Jormunth/EUC_Blinker_CPELyon/IMU/data_processing/peak_detection/img/peak_detection_2_shake_right.png

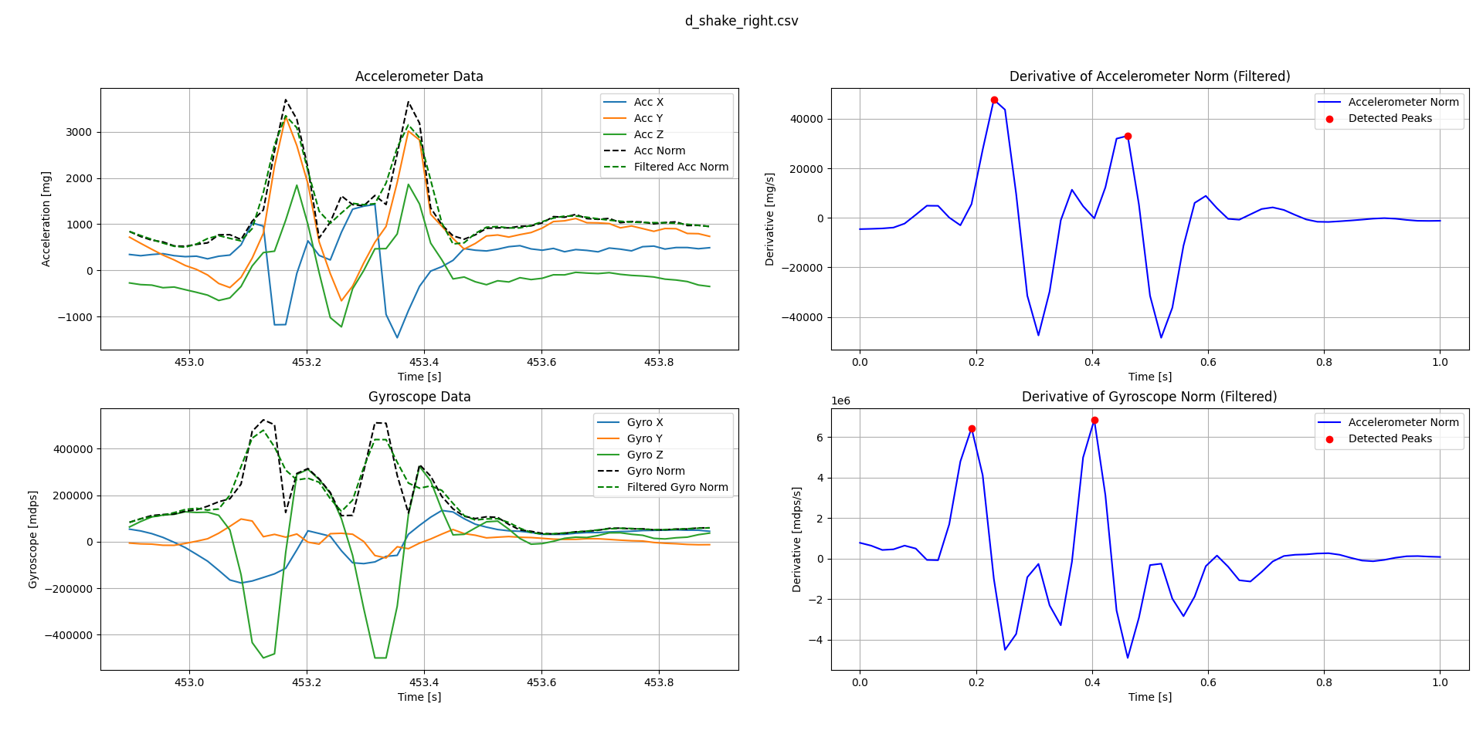
IMU/data_processing/peak_detection/img/peak_detection_2_shake_right.png
