Jormunth/EUC_Blinker_CPELyon/IMU/img/illustration.png

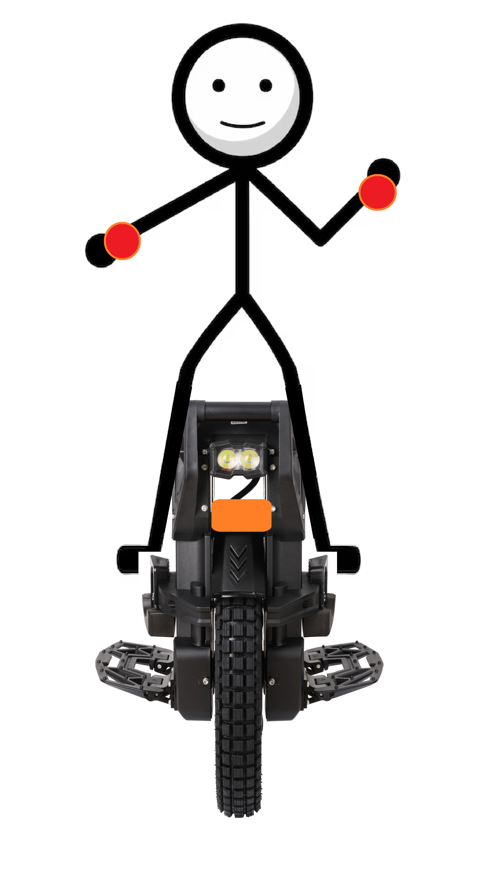
IMU/img/illustration.png
