Jormunth/EUC_Blinker_CPELyon/IMU/img/jack_port_HW.jpg

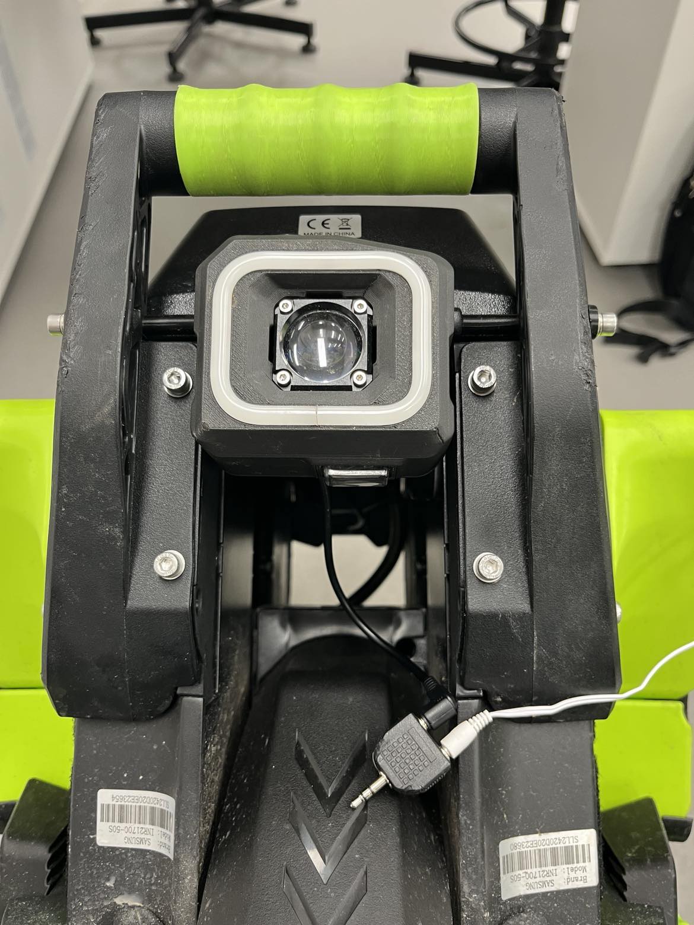
IMU/img/jack_port_HW.jpg
