Jormunth/EUC_Blinker_CPELyon/TOF/img/capteur_valor.png

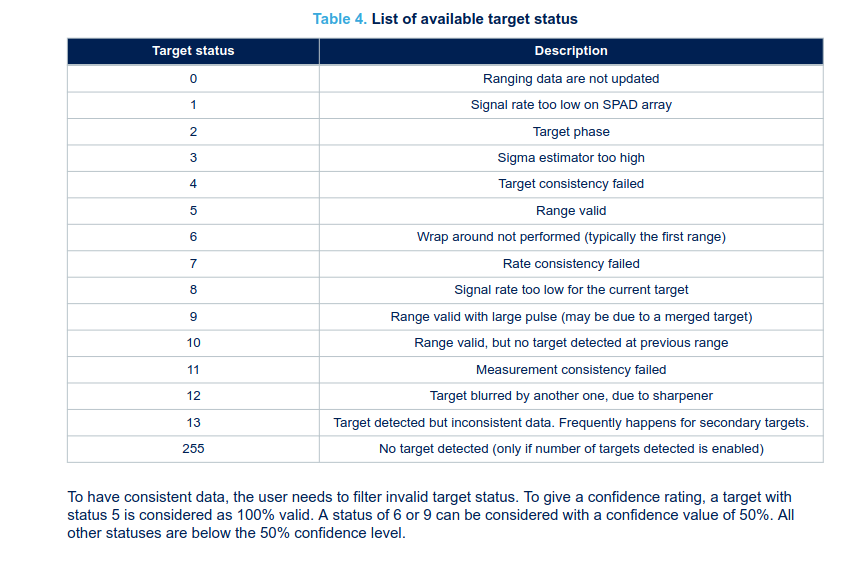
TOF/img/capteur_valor.png
