Jormunth/EUC_Blinker_CPELyon/TOF/img/serial_gui.png

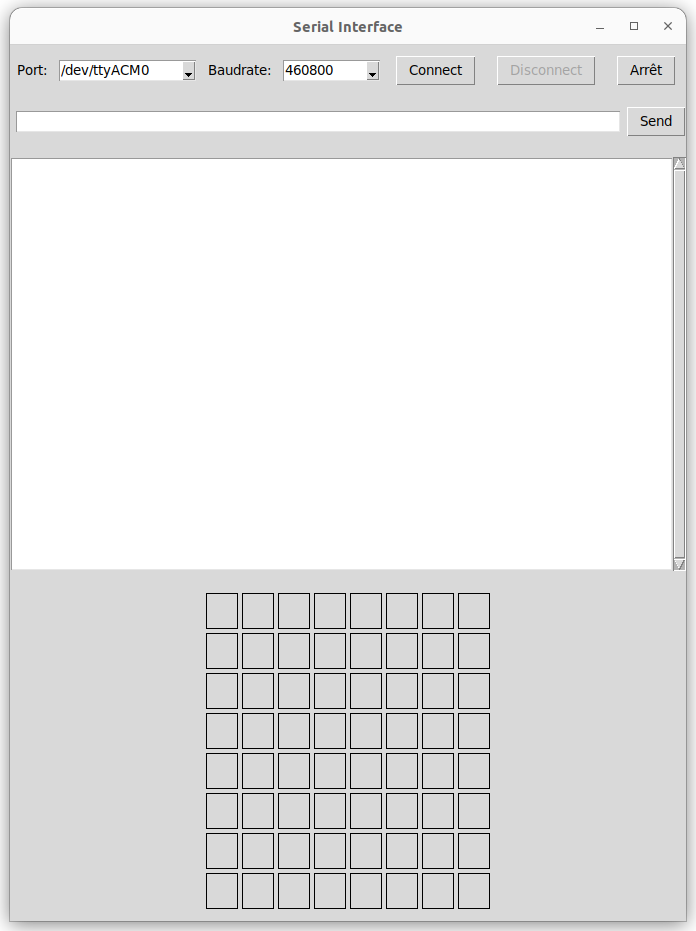
TOF/img/serial_gui.png
