Jormunth/EUC_Blinker_CPELyon/IMU/data_processing/peak_detection/logs/saturation_test.csv

# IKS01A3
time[us] | acc_x[mg] | acc_y[mg] | acc_z[mg] | gyro_x[mdps] | gyro_y[mdps] | gyro_z[mdps]
1092189000 | 1050 | 42 | -43 | -2045 | -1404 | -351
1092208000 | 1055 | 40 | -41 | -1954 | -1450 | -366
1092227000 | 1045 | 39 | -43 | -2091 | -1404 | -244
1092246000 | 1048 | 43 | -40 | -2015 | -1419 | -305
1092265000 | 1048 | 43 | -50 | -1954 | -1404 | -290
1092284000 | 1051 | 45 | -42 | -1938 | -1419 | -213
1092303000 | 1048 | 41 | -48 | -2152 | -1297 | -351
1092322000 | 1055 | 44 | -44 | -2061 | -1358 | -381
1092341000 | 1054 | 41 | -51 | -2091 | -1358 | -274
1092360000 | 1047 | 38 | -42 | -2213 | -1465 | -351
1092379000 | 1056 | 44 | -45 | -2091 | -1419 | -335
1092398000 | 1051 | 39 | -42 | -2000 | -1404 | -335
1092417000 | 1046 | 40 | -36 | -2030 | -1282 | -137
1092436000 | 1053 | 43 | -43 | -2076 | -1206 | -305
1092455000 | 1050 | 46 | -41 | -1893 | -1480 | -305
1092474000 | 1051 | 39 | -48 | -2091 | -1419 | -351
1092493000 | 1052 | 46 | -38 | -2061 | -1297 | -290
1092512000 | 1053 | 46 | -36 | -2000 | -1312 | -290
1092531000 | 1053 | 38 | -52 | -1954 | -1450 | -351
1092550000 | 1049 | 42 | -50 | -1984 | -1496 | -458
1092569000 | 1044 | 39 | -45 | -2030 | -1511 | -335
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
