Jormunth/EUC_Blinker_CPELyon/IMU/data_processing/peak_detection/logs/test_d_shake.csv

# IKS01A3
time[us] | acc_x[mg] | acc_y[mg] | acc_z[mg] | gyro_x[mdps] | gyro_y[mdps] | gyro_z[mdps]
23576000 | 944 | 349 | 254 | -2992 | -2000 | -946
23595000 | 932 | 368 | 243 | -1190 | -1175 | -1832
23614000 | 959 | 339 | 247 | -656 | -1312 | 625
23633000 | 965 | 311 | 246 | -2427 | -3328 | 183
23652000 | 940 | 337 | 245 | -2000 | -3083 | -442
23671000 | 947 | 319 | 244 | -2580 | -2900 | -1404
23690000 | 923 | 358 | 247 | -2854 | -3022 | -183
23709000 | 934 | 346 | 250 | -1877 | -3053 | 610
23728000 | 928 | 353 | 256 | -534 | -2167 | 1190
23747000 | 931 | 314 | 250 | 15 | -1114 | 2091
23766000 | 929 | 312 | 250 | -870 | -1557 | 1312
23785000 | 921 | 316 | 230 | -1648 | -1251 | 2977
23804000 | 898 | 328 | 231 | -2274 | -763 | 4595
23823000 | 893 | 331 | 236 | -2167 | 1435 | 5267
23842000 | 912 | 323 | 236 | -2305 | 2045 | 5099
23861000 | 923 | 334 | 243 | -2076 | 2366 | 5526
23880000 | 918 | 340 | 243 | -2335 | 2732 | 6045
23899000 | 929 | 331 | 248 | -2854 | 2854 | 7938
23918000 | 929 | 324 | 251 | -2534 | 3618 | 9923
23937000 | 959 | 289 | 240 | -2732 | 3908 | 8687
23956000 | 965 | 277 | 245 | -4381 | 4229 | 8274
23975000 | 995 | 279 | 260 | -5954 | 3786 | 5893
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
