Jormunth/EUC_Blinker_CPELyon/IMU/data_processing/turn_detection/logs/test1.csv

Timestamp | Data
2025-01-20T15:13:03.856857 | 176.57 | 1.08 | -3.77
2025-01-20T15:13:03.857879 | 176.57 | 1.09 | -3.77
2025-01-20T15:13:03.870691 | 176.57 | 1.10 | -3.77
2025-01-20T15:13:03.886467 | 176.56 | 1.11 | -3.77
2025-01-20T15:13:03.887480 | 176.55 | 1.12 | -3.77
2025-01-20T15:13:03.901293 | 176.54 | 1.14 | -3.78
2025-01-20T15:13:03.902751 | 176.52 | 1.15 | -3.79
2025-01-20T15:13:03.916365 | 176.50 | 1.17 | -3.79
2025-01-20T15:13:03.946944 | 176.48 | 1.18 | -3.80
2025-01-20T15:13:03.947955 | 176.45 | 1.20 | -3.79
2025-01-20T15:13:03.960804 | 176.43 | 1.22 | -3.80
2025-01-20T15:13:03.961812 | 176.39 | 1.23 | -3.81
2025-01-20T15:13:03.975381 | 176.37 | 1.24 | -3.82
2025-01-20T15:13:03.983849 | 176.33 | 1.25 | -3.83
2025-01-20T15:13:03.990965 | 176.29 | 1.26 | -3.84
2025-01-20T15:13:03.991976 | 176.25 | 1.26 | -3.84
2025-01-20T15:13:04.006656 | 176.20 | 1.26 | -3.85
2025-01-20T15:13:04.020812 | 176.14 | 1.26 | -3.86
2025-01-20T15:13:04.021796 | 176.09 | 1.26 | -3.88
2025-01-20T15:13:04.051287 | 176.02 | 1.26 | -3.89
2025-01-20T15:13:04.052299 | 175.95 | 1.26 | -3.90
2025-01-20T15:13:04.053486 | 175.86 | 1.26 | -3.90
2025-01-20T15:13:04.066063 | 175.78 | 1.26 | -3.92
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
