Jormunth/EUC_Blinker_CPELyon/IMU/data_processing/turn_detection/logs/test3.csv

Timestamp | Data
2025-01-20T15:15:21.084162 | -4.85 | -0.59 | -1.80
2025-01-20T15:15:21.099340 | -4.85 | -0.59 | -1.77
2025-01-20T15:15:21.129811 | -4.86 | -0.61 | -1.74
2025-01-20T15:15:21.143798 | -4.86 | -0.63 | -1.72
2025-01-20T15:15:21.158805 | -4.86 | -0.64 | -1.72
2025-01-20T15:15:21.219418 | -4.86 | -0.65 | -1.76
2025-01-20T15:15:21.234577 | -4.89 | -0.72 | -1.72
2025-01-20T15:15:21.278609 | -4.90 | -0.75 | -1.73
2025-01-20T15:15:21.280070 | -4.91 | -0.77 | -1.74
2025-01-20T15:15:21.294441 | -4.92 | -0.78 | -1.75
2025-01-20T15:15:21.323464 | -5.02 | -0.92 | -1.82
2025-01-20T15:15:21.338958 | -5.02 | -0.92 | -1.84
2025-01-20T15:15:23.620040 | -6.58 | -7.30 | -1.60
2025-01-20T15:15:23.626132 | -6.41 | -7.32 | -1.53
2025-01-20T15:15:23.677865 | -6.23 | -7.39 | -1.42
2025-01-20T15:15:23.738283 | -6.00 | -7.42 | -1.29
2025-01-20T15:15:23.739703 | -5.75 | -7.44 | -1.18
2025-01-20T15:15:23.858403 | -5.47 | -7.42 | -1.12
2025-01-20T15:15:23.859567 | -5.15 | -7.39 | -1.05
2025-01-20T15:15:23.860665 | -4.81 | -7.36 | -1.01
2025-01-20T15:15:24.037543 | -4.30 | -4.11 | -2.26
2025-01-20T15:15:24.097841 | -4.36 | -3.82 | -2.35
2025-01-20T15:15:24.157722 | -4.40 | -3.80 | -2.09
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
