Jormunth/EUC_Blinker_CPELyon/TOF/Firmware/STM_32_serial/VL53L8CX_SimpleRanging/VL53L8CX_SimpleRanging.ioc

Mcu.UserName=STM32F401RETx
PA13.GPIO_Label=TMS
PA13.Signal=SYS_JTMS-SWDIO
PA14.GPIO_Label=TCK
PA14.Signal=SYS_JTCK-SWCLK
PA2.Signal=USART2_TX
PA3.Signal=USART2_RX
PA4.Signal=GPXTI4
PA5.GPIO_Label=LD2 [Green Led]
PA5.Signal=GPIO_Output
PA7.Signal=GPIO_Output
PB0.Signal=GPIO_Output
PB3.GPIO_Label=SWO
PB3.Signal=SYS_JTDO-SWO
PB8.Signal=I2C1_SCL
PB9.Signal=I2C1_SDA
PC13-ANTI_TAMP.GPIO_Label=B1 [Blue PushButton]
PC13-ANTI_TAMP.Signal=GPXTI13
PC14-OSC32_IN.Signal=RCC_OSC32_IN
PC15-OSC32_OUT.Signal=RCC_OSC32_OUT
