Jormunth/EUC_Blinker_CPELyon/(commit log)

2025-01-06 MEMS data acquisition and logger
    [ble_mpu6050_logs.csv]
2025-01-07 TOF serial GUI fonctionnelle
    [archive_20250107_141829.csv, archive_20250107_142311.csv, archive_20250107_142500.csv, archive_20250107_144902.csv, archive_20250107_145005.csv, archive_20250107_145038.csv, archive_20250107_145111.csv, archive_20250107_145206.csv]
2025-01-07 TOF ble gui
    [archive_20250107_162313.csv]
2025-01-07 IMU visualizer
    [ble_mpu6050_logs.csv]
2025-01-07 fin de journée 2
    [archive_20250107_173458.csv, archive_20250107_173746.csv]
2025-01-07 changed BLE logger format
    [ble_mpu6050_logs.csv]
2025-01-08 modif gui
    [archive_20250108_100935.csv, archive_20250108_101626.csv, archive_20250108_102820.csv]
2025-01-08 fin day 3
    [archive_20250108_150324.csv, archive_20250108_161807.csv, archive_20250108_164744.csv]
2025-01-10 connextion BLE fonctionne
    [archive_20250107_141829.csv, archive_20250107_142311.csv, archive_20250107_142500.csv, archive_20250107_144902.csv, archive_20250107_145005.csv, archive_20250107_145038.csv, archive_20250107_145111.csv, archive_20250107_145206.csv]
2025-01-13 ble logger new
    [out.csv]
2025-01-13 imu logger
    [ble_mpu6050_logs.csv]
2025-01-13 IMU logger BLE
    [Data_Log_25_01_13_14_20_29.csv, out.csv]
2025-01-13 update FW hand
    [out.csv]
2025-01-14 gesture recognition start algo
    [chest_tap.csv, d_shake_left.csv, d_shake_right.csv, other.csv, out.csv, saturation_test.csv, stationnary.csv, test_d_shake.csv]
2025-01-14 debugging in progress classification IMU
2025-01-17 implemented IMU fusion
2025-01-17 logged ypr imu
    [archive_20250117_151727.csv, archive_20250117_151937.csv, archive_20250117_152117.csv, archive_20250117_152334.csv, archive_20250117_165202.csv]
2025-01-17 logs and start plotting imu orientation ypr
    [archive_20250117_165202.csv, archive_20250117_172012.csv, lane.csv, test.csv, turn.csv, turn2.csv]
2025-01-17 commit defin de journée
    [labeled_data_20250115_145946.csv, labeled_data_20250115_150252.csv, labeled_data_20250115_150326.csv, labeled_data_20250115_150413.csv, labeled_data_20250115_150421.csv, labeled_data_20250115_172921.csv, labeled_data_20250115_173101.csv, labeled_data_20250117_100133.csv]
2025-01-20 réseau créer
    [1.csv, 2.csv, 3.csv, 4.csv, archive_20250117_151727.csv, archive_20250117_151937.csv, archive_20250117_152117.csv, archive_20250117_152334.csv]
2025-01-21 end of turn detection
    [lane.csv, left_lane.csv, ligne.csv, right_lane.csv, test.csv, test1.csv, test3.csv, turn.csv]
2025-01-21 ajout V1
    [archive_20250121_100219.csv, archive_20250121_120442.csv, archive_20250121_133230.csv]
2025-01-21 v2 fonctionelle
    [archive_20250121_162151.csv, archive_20250121_162836.csv]
2025-01-22 led strip controller
2025-01-22 continue cleaning git
    [Data_Log_25_01_13_14_20_29.csv]
2025-01-22 cleaned main branch
    [archive_20250117_151727.csv, archive_20250117_151937.csv, archive_20250117_152117.csv, archive_20250117_152334.csv, archive_20250117_172012.csv, chest_tap.csv, d_shake_left.csv, d_shake_right.csv]
2025-01-22 renamed some files
    [archive_20250117_151727.csv, archive_20250117_151937.csv, archive_20250117_152117.csv, archive_20250117_152334.csv, archive_20250117_172012.csv, chest_tap.csv, d_shake_left.csv, d_shake_right.csv]
2025-01-22 repo propre
    [1.csv, 2.csv, 3.csv, 4.csv, archive_20250109_104235.csv, archive_20250109_104400.csv, archive_20250109_105805.csv, archive_20250109_111352.csv]
2025-01-22 + hand module HW diagram + led status (BLE, IMU)
2025-01-22 IMU readme, in progress
2025-01-22 imu features added to readme
2025-01-22 edit legend IMU illustration
2025-01-23 IMU algo description done
2025-01-23 finished IMU readme
2025-01-23 rm authors imu
